zthxxx/STM32-Contiki_Sensor_Smart_Home/Doc/readme.txt

STM32串口驱动ESP8266 wifi模块STA TCP Client模式

引脚连接：
ESP8266_UTXD  --- STM32_A3(UART2_RXD)
ESP8266_URXD  --- STM32_A2(UART2_TXD)
ESP8266_VCC   --- STM32_3V3
ESP8266_GND   --- STM32_GND
ESP8266_RST   --- STM32_A1

配置路由器wifi SSID KEY、TCP Server后，开机自动连接  并发数据测试。
PC连接UART1，通信链路如下：
UART1 <--> UART2 <--> ESP8266 <--> 路由器 <--> TCP server
通信数据收发及显示均正常。
