zthxxx/STM32-Contiki_Sensor_Smart_Home/Documents/2016年四川省TI杯大学生电子设计竞赛题D-简易电子秤.docx

2016年TI杯

四川省大学生电子设计竞赛

D题：简易电子秤

设 计 报 告

日期：2016年 7月 28日

摘 要

本作品设计的是一个以电阻应变片为称重传感器的简易悬挂电子秤，被测重物体的重量值能在OLED屏幕上以克为单位精确的实时显示，并且可以进行单价设置，将自动换算物体的价格并同步实时显示，金额累加的功能可使得多次测量的累计总价显示观测。本电子秤也具有去皮校准、单位换算、超重报警等一系列功能。

本次题目要求测量范围为5.00g~500g，误差范围为不超过50g误差小于0.5g,50g至500g，误差小于1g；而本作品的电子秤称重范围可达1.00g~600g；重量小于50g，称重误差小于0.3g；重量在50g及以上，称重误差小于0.4g。

关键词：电子秤；电阻应变片；称重传感器；OLED显示

Abstract

This work is designed as a resistance strain gauge load cell suspension Simple electronic scales, the weight value of the measured object can be heavy on the OLED screen in grams accurate real-time display, and the unit price can be set to automatic conversion the price of the object and synchronizes real-time display, the amount of cumulative function makes multiple measurements show the cumulative total price observation. The electronic scales are calibrated with a peeled, unit conversion, and a series of overweight alarm function.

The measurement range of questions asked 5.00g ~ 500g, the error range of not more than 50g error is less than 0.5g, 50g to 500g, error is less than 1g; electronic weighing scales and scope of the work up to 1.00g ~ 600g; weight of less than 50g Weighing error is less than 0.3g; weight 50g and above, weighing error is less than 0.4g.

Keywords: Electronic scale; resistance strain gauges; weighing sensors; OLED display

目 录

简易电子秤（D题）

【本科组】

# 一、系统方案的论证

本系统主要由传感器模块、放大及AD转换模块、控制模块、显示模块、键盘模块、报警模块、电源模块组成。

## 1、自制传感器方案的论证与选择

根据本题目要求，称重传感装置需自制，悬臂梁需采用铁质材料。依据电阻应变效应及惠斯登电桥原理，在铁质悬臂梁上粘贴电阻应变片作为称重传感器。惠斯登电桥应变计有多重接线方式。

方案一：采用单臂电桥接线法。

单臂电桥接线方式如图1.1所示，利用应变片R1作为工作片，R2、R3、R3为固定电阻。应变片沿着受力方向平整安装在悬梁臂上，安装方式如图1.2所示。

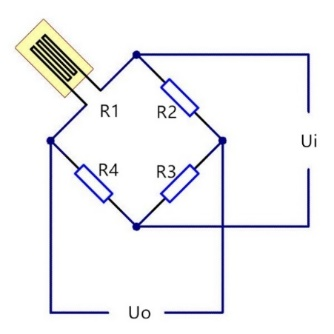
[picture p3: figure]
1_副本

图1.1 单臂电桥接线方式 图1.2 单臂电桥应变片安装方式

应变片本身灵敏度较低，铁质悬臂梁只产生轻微形变，所以采用单臂电桥接线方式构成的传感器灵敏度比较低。传感器输出的电压信号不利于的采集和处理。

方案二：双臂全桥接线法。

双臂全桥接线方式如图1.3所示，R1、R2、R3、R4四个应变片作为工作片，搭成惠斯登电桥。R1、R3平行安装在悬梁臂同一侧，R2、R4平行安装在悬梁臂另一侧，R1、R3和R2、R4的受力方向相反，安装方式如图1.4所示。

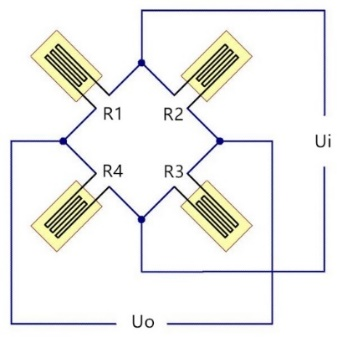
[picture p4: figure]
2_副本

图1.3 双臂全桥接线方式 图1.4 双臂全桥应变片安装方式

采用双臂全桥接线法构成的传感器的灵敏度为单臂电桥的4倍，并使输入和输出呈线性关系。利用桥式电路检测应变片的变化，还具有通过的电流极低，应变片自身发热低的优点。

综合以上两种方案，选择方案二作为自制传感器方案。

## 2、放大及AD转换电路的论证与选择

方案一：利用精密仪用放大器和AD转换芯片

利用精密仪用放大器,如INA128、INA129等搭建增益电路将传感器输出的微弱电压信号进行放大利于AD芯片的采集。利用AD转换芯片，如AD7705、AD7714等搭建AD转换电路将电压模拟信号转换为数字信号利于单片机对数据的处理。

此种方案是一种较为常规的微小电压采集方案，能满足本题目中设计的要求，但电路相对复杂，调试时较为麻烦。

方案二：利用专为高精度电子秤而设计的24位A/D转换器芯片HX711。HX711片内集成了低噪声可编程放大器，可编程增益为128或 64，对应的满额度差分输入信号幅值分别为±20mV或±40mV。芯片内提供的稳压电源可以直接向外部传感器和芯片内的 A/D 转换器提供电源。HX711采用简单的数字控制和串口通讯，所有控制由管脚输入，芯片内寄存器无需编程，便于单片机控制。

此方案利用专用芯片来实现电压增益和AD转换，能很好的完成对传感器微小电压的采集，外围电路简单，调试方便。

综合以上两种方案，选择方案二作为增益及A/D转换电路。

## 3、控制系统的论证与选择

方案一：使用ST公司的STM32F103RCT6单片机做为主控芯片，它以运行速度快以及性能稳定可靠而被广泛应用于一些需要复杂运算的工程中。

方案二：采用51系列单片机作为控制器，成本低，但所需外围电路复杂。存储容量较小，运行速度较慢。

根据本设计要求，综合以上两种方案，选择方案一的主控芯片。

## 4、显示模块的论证与选择

方案一：采用OLED作为显示器，OLED无需背光灯，采用非常薄的有机材料涂层和玻璃基板，当有电流通过时，这些有机材料就会发光。而且OLED显示屏幕可以做得更轻更薄，可视角度更大，并且能够显著节省电能。

方案二：采用LCD作为液晶显示屏，LCD本身不发光，需要背光源。其由TFT基板与CF（彩膜）基板贴合而成，内充液晶。通过TFT基板提供电场来控制液晶旋转的角度，从而起到控制液晶穿透率的作用。但LCD耗能相对较高。
根据本设计要求，综合以上两种方案，选择方案一。

# 二、系统理论分析与计算

## 1、电阻应变的分析

金属导线的电阻R与其长度L成正比，与其截面积A成反比，即 R=ρL/A ，其中ρ是导线的电阻率。如果导线沿其轴线方向受力产生形变，则其电阻值也随之发生变化，这一物理现象被称为金属导线的应变——电阻效应。当导线沿其轴线放线受力被拉长时，导线长度L增大，截面积A减小，导线的阻值R就会随之增大。反之，当导线沿其轴线放线受力被挤压时，导线的阻值R会随之减小。

本题目要求利用电阻应变片自制铁质传感器，铁质材料的导热能力强，温度因素对铁材料的物理属性影响较大，为了避免电阻应变片发热对铁质传感器形变造成影响，应尽量减小通过应变片电流，本设计选用的电阻应变片阻值为1000Ω。传感器输入电压Ui为5V左右，电阻桥的平衡阻值为： R=(（R2+R3）（R1+R4）)/(R1+R2+R3+R4)=1K ，流过应变片的电流约为： I=(Ui)/R=5mA 。

## 2、应变电阻桥的分析

应变电阻桥如图2.1所示，输入输出电压与应变电阻的关系如下：

Ui=((R1R3-R2R4)/((R1+R2)(R3+R4)))Uo (2-1)

R1R3=R2R4时，电阻桥为平衡桥。随着悬臂梁受重物的拉力而形变时应变电阻阻值发生改变：

ΔUi=Uo(R1R2)/((R1+R2)^2)((ΔR1)/(R1)-(ΔR2)/(R2)+(ΔR3)/(R3)-(ΔR4)/(R4)) (2-2)

为常数值，ε—金属材料的轴向应变值,即ε=ΔL/L，因此又称ε为长度应变值,对金属丝而言,其值在0.24~0.4之间）：

ΔUi=(KUo)/4(ε1-ε2+ε3-ε4) (2-3)

所以应变电阻全桥读数为单臂电桥的4倍。

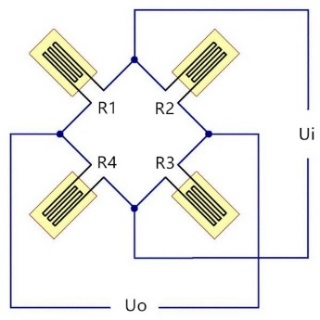
[picture p5: figure]
2_副本

图2.1 双臂全桥原理图

# 三、电路与程序设计

## 1、电路的设计

### （1）系统总体框图

系统总体框图如图3.1所示。

图3.1 系统总体框图

### （2）放大及AD转换电路原理图

放大及AD转换电路如图3.2所示，HX711片内稳压电路为自制重量传感器提供电源，传感器反馈的微弱模拟电压信号由HX711通道A正负输入端（INPA、INNA）进入芯片内进行放大和AD转换，AD转换后的数字信号通过简单的串口通讯（PD_SCK、DOUT）输入到单片机。将HX711 15脚RATE拉高，设定输出数据速率为80HZ。

图3.2 放大及AD转换电路

### （3）键盘输入、OLED显示及报警电路

本题目中电子秤需要进行数字输入，并且要实现单价去皮等功能，需要用到的按键较多，同时为了减少I/O口的占用，采用4x5矩阵键盘完成数字及功能输入。

显示部分采用1.3寸蓝色OLED显示屏，该显示屏采用SPI与单片机通信，纵向显示4行字符，纵向显示16个字符，能完成重量、价格及其他基本信息的显示。

报警电路由LED及蜂鸣器组成，低电平触发。

图3.3 键盘输入及OLED显示电路

### （4）控制系统电路原理图

图3.4 控制系统电路

### （5）电源模块

电源由两节18650电池加滤波部分、稳压部分组成。为整个系统提供+5V或者+3.3V电压，确保电路的正常稳定工作。18650锂电池可由电源适配器充电，为保证电池使用寿命，在充电时，电池与系统自动断开，系统断电。电路简单可靠，均采用三端稳压管实现，原理图如图3.5所示。

图3.5 电源模块电路

## 2、程序的设计

### （1）程序功能描述与设计思路

1、程序功能描述

根据题目要求软件部分主要分为称重传感器数据的采集、实现键盘的设置和显示。

1）键盘部分功能：单价设置输入、切换单位、实现价格累加和去皮功能。

2）显示部分：实现显示重量、价格、单价、总价、错误提示等功能。

2、程序设计思路

根据题目要求，将软件系统分为数据采集、界面显示、人机交互三大部分，各部分采用多个进程协同完成功能，每个进程职责单一。通过Contiki嵌入式操作系统进行各部分任务进程的调度。

1） 数据采集主要涉及AD芯片的读取，采集应变片变化，并通过数字滤波FIR处理数据，并转为所需要的重量数据。
2） 界面显示部分是将重量信息，价格、单价、总价等信息，统一格式显示在屏幕上。
3） 人机交互部分是通过按键队列产生按键事件驱动不同的进程响应操作，以实现设置单价、累加价格、去皮校零的逻辑功能。

### （2）程序流程图

1、主程序流程图

图3.6 系统主程序流程框图

2、测重子程序流程图

图3.7 测重流程图

测重部分软件难点在于原则合适的数字滤波器对噪声和干扰的过滤，选择合适的算法做偏差校正，此部分借助于Matlab等工具对测量数据进行分析，帮助滤波器的选择。

3、按键子程序流程图

图3.8 按键驱动流程图

本部分按键驱动程序仿照Linux系统中按键队列、消息机制及虚拟按键映射的实现过程，写出了对应本操作系统Contiki的实现代码。

4、交互业务子程序流程图

图3.9 交互业务实现流程图

业务进程均为独立进程，电子秤总进程直接获取按键事件，并根据需要按照按键类型触发所需要的具体应用业务进程，实现各功能模块与系统之间的松耦合。

# 四、测试方案与测试结果

## 1、测试方案

将电子秤放置于水平平稳桌面，为电子秤提供稳定电源，依次向托盘中放入不同重量的标称砝码，将砝码值和所测重量值记录于表中，反复测量3次，计算精度。然后再进行功能测试，先后测试电子秤的单价设置功能、物品金额计算功能、金额累加功能、去皮功能、单位换算功能，并将测试结果记录于表中。

## 2、测试条件与仪器

测试条件：检查多次，仿真电路和硬件电路必须与系统原理图完全相同，并且检查无误，硬件电路保证无虚焊。

测试环境：8.4V电池供电，室温28℃。

测试仪器：标准砝码。

## 3、测试结果及分析

### （1）测试结果(数据)

称重测试

测试结果如下表所示： （单位/g）

表4-1 重量测试结果表

砝码值 | 1 | 5 | 10 | 50 | 100 | 200 | 300 | 500 | 600
测试值 | 1.03 | 4.99 | 10.05 | 49.98 | 99.98 | 199.92 | 299.92 | 500.03 | 600.01
误差 | 0.03 | 0.01 | 0.05 | 0.02 | 0.02 | 0.08 | 0.08 | 0.03 | 0.01

功能测试与结果分析

测试结果如下表所示： （单位/g）

表4-2 功能测试结果表

功能 | 设置单价 | 计算金额 | 金额累加 | 去皮 | 去皮 | 单位换算 | 超重报警
设置值 | 10元/g | 10g重物 10元/g | 125元 累加5次 | 58g 去皮 | 101g 去皮 | 100g重物 | 502g重物
测试结果 | 10.00元/g | 100.00元 | 625.00元 | 0.00g | 去皮超重 | 10两 | 声光报警

### （2）测试分析与结论

根据上述对电子秤称重数据的分析和功能的验证，由此可以得出以下结论：

1、称重范围为1.00g~600g，超过题目要求；

2、称重误差全部在0.5g以下；

3、电子秤能够实现单价设置功能，并能实现相应的金额计算和累加；

4、能够实现去皮功能，去皮范围为100g；

5、能实现单位换算功能，能实现国际单位制（克）与中国市制（两）的换算；

6、当称重重量超过500g时，为保护电子秤超重声光报警触发。

综上所述，本设计达到设计要求。

# 五、结论与心得

自制传感器是本题目最大的难点，从铁质材料的选取到应变片的粘贴再到力臂的长度都需要考虑，任何一点因数或者干扰都会影响数据的读取。在我们不断的奋战中，在多组测试结果中选取了线性度高，自恢复性良好的材质，使用全桥方式的应变片贴法，再加上程序上给予的多种软件数字滤波组合，最终终于得到了稳定高精度的数据输出。种种困难并没有让我们放弃，在这次比赛的不断奋斗中，我们最终完成设计，达到要求。

# 六、参考文献

[1] 谭浩强.C语言程序设计[M].北京:清华大学出版社,2012

[2] 尹福严.金属箔式应变片制作原理 [M].北京:国防工业出版社,2011

[3] 刘鸿文.材料力学 第五版[M].北京:高等教育出版社,2011

[4] 周真，苑惠娟.传感器原理与运用[M].北京:清华大学出版社,2011

[5] 童敏明，唐守峰. 传感器原理与检测技术[M].北京:机械工业出版社,2014

# 附录1：电路原理图

# 附录2：源程序

PROCESS_THREAD(HX711_read_weight_process, ev, data)

{

double HX711_Weight = 0.0;

static struct etimer et;

PROCESS_BEGIN();

while(1)

{

if(HX711_Get_DAT_Pin_State())

{

Contiki_etimer_DelayMS(10);

}

HX711_Weight = HX711_Window_Weighting_Filter();

// printf("FLITER!! : %lf\r\n",HX711_Weight);

// printf("%d\r\n",HX711_Read_Value()/100);

HX711_Weight_GlobalData = HX711_Weight;

Steelyard_CurrentlyWeight = HX711_Weight;

}

PROCESS_END();

}

PROCESS_THREAD(OLED_Show_Increment_process, ev, data)

{

static struct etimer et;

static uint8_t last_length[2] = {16,16};

PROCESS_BEGIN();

while(1)

{

OLED_ShowFloat(

Steelyard_Weight_Row,

Steelyard_Display_Row_Head_Length[Steelyard_Weight_Row],

16 - Steelyard_Display_Row_Endding_Length[Steelyard_Weight_Row],

Steelyard_Convert_Unit_Weight_Method[Steelyard_Unit_index](HX711_Weight_GlobalData),

&last_length[0]

);

OLED_ShowFloat(

Steelyard_Price_Row,

Steelyard_Display_Row_Head_Length[Steelyard_Price_Row],

15,

Steelyard_Get_CurrentlyPrice(),

&last_length[1]

);

OLED_Refresh_Gram();//更新显示

Contiki_etimer_DelayMS(500);

}

PROCESS_END();

}

PROCESS_THREAD(Steelyard_Display_Peeling_Error_process, ev, data)

{

static struct etimer et;

PROCESS_BEGIN();

Steelyard_Display_Peeling_Overweight();

OLED_Refresh_Gram();//更新显示

Contiki_etimer_DelayMS(2000);

OLED_Fill_Alphabet(Steelyard_Peeling_Overweight_Row,0,16);

PROCESS_END();

}

PROCESS_THREAD(KEYBOARD_Scan_process, ev, data)//keyboard scan, follow the typical keyboard scan code

{

static uint8_t Keyboard_Button_Index = 0;

static struct etimer et;

PROCESS_BEGIN();

keyboard_press_event = process_alloc_event();

while(1)

{

Keyboard_Button_Index = KEYBOARD_Read_Button();

if(Keyboard_Button_Index == 0)

{

Contiki_etimer_DelayMS(50);

continue;

}

Contiki_etimer_DelayMS(50);

if(KEYBOARD_Read_Button() == Keyboard_Button_Index)

{

printf("Key down %d\r\n", Keyboard_Button_Index);

KEYBOARD_Push_Button_IntoQueue(Keyboard_Button_Index);

process_post(&Steelyard_Load_Key_process, keyboard_press_event, (void *)Keyboard_Button_Index);

Keyboard_Button_Index = 0;

}

while(KEYBOARD_Read_Button() != 0)

{

Contiki_etimer_DelayMS(50);//放开按键

}

//按键已释放

}

PROCESS_END();

}

PROCESS_THREAD(Steelyard_Load_Key_process, ev, data)

{

uint8_t key_index = NULL;

PROCESS_BEGIN();

while(1)

{

PROCESS_WAIT_EVENT_UNTIL(ev == keyboard_press_event);

while(KEYBOARD_Get_Button_Queue_Size() > 0)

{

key_index = KEYBOARD_Get_Top_Button();

if((key_index == NULL) || (Steelyard_Get_MapVirtualKey(key_index) == NULL))continue;

Steelyard_Key_Dispose_Method[Steelyard_Get_Key_Type(key_index)](Steelyard_Get_MapVirtualKey(key_index));

}

}

PROCESS_END();

}
