zthxxx/STM32-Contiki_Sensor_Smart_Home/Documents/resource/images/硬件系统框图.png

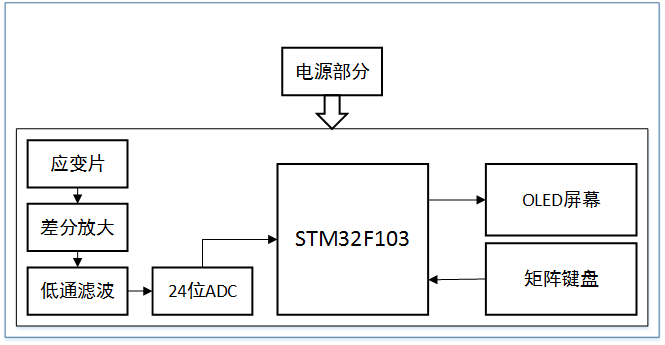
Documents/resource/images/硬件系统框图.png
