zthxxx/STM32-Contiki_Sensor_Smart_Home/Hardware/DHT11/dht11.c

#include "dht11.h"
#include "delay.h"

 //////////////////////////////////////////////////////////////////////////////////	 
//本程序只供学习使用，未经作者许可，不得用于其它任何用途
//ALIENTEK战舰STM32开发板
//DHT11数字温湿度传感器驱动代码	   
//正点原子@ALIENTEK
//技术论坛:www.openedv.com
//修改日期:2012/9/12
//版本：V1.0
//版权所有，盗版必究。
//Copyright(C) 广州市星翼电子科技有限公司 2009-2019
//All rights reserved									  
//////////////////////////////////////////////////////////////////////////////////
      
//复位DHT11
void DHT11_Out()
{
	GPIO_InitTypeDef  GPIO_InitStructure;
	GPIO_InitStructure.GPIO_Pin = DHT11_GPIO_Pin;
 	GPIO_InitStructure.GPIO_Mode = GPIO_Mode_Out_PP; 		 //推挽输出
 	GPIO_Init(DHT11_GPIO_Port, &GPIO_InitStructure);				 //初始化IO口
}
void DHT11_IN()
{
	GPIO_InitTypeDef  GPIO_InitStructure;
	GPIO_InitStructure.GPIO_Pin = DHT11_GPIO_Pin;
 	GPIO_InitStructure.GPIO_Mode = GPIO_Mode_IPU; 		 //推挽输出
 	GPIO_Init(DHT11_GPIO_Port, &GPIO_InitStructure);				 //初始化IO口
}
void DHT11_Rst(void)	   
{                 
	DHT11_Out(); 	//SET OUTPUT
    DHT11_DQ_OUT=0; 	//拉低DQ
    Delay_NOP_ms(50);    	//拉低至少18ms
    DHT11_DQ_OUT=1; 	//DQ=1 
	Delay_NOP_us(60);     	//主机拉高20~40us
}
//等待DHT11的回应
//返回1:未检测到DHT11的存在
//返回0:存在
uint8_t DHT11_Check(void) 	   
{   
	uint8_t retry=0;
	DHT11_IN();//SET INPUT	 
    while (DHT11_DQ_IN&&retry<100)//DHT11会拉低40~80us
	{
		retry++;
		Delay_NOP_us(1);
	};	 
	if(retry>=100)return 1;
	else retry=0;
    while (!DHT11_DQ_IN&&retry<100)//DHT11拉低后会再次拉高40~80us
	{
		retry++;
		Delay_NOP_us(1);
	};
	if(retry>=100)return 1;	    
	return 0;
}
//从DHT11读取一个位
//返回值：1/0
uint8_t DHT11_Read_Bit(void) 			 
{
 	uint8_t retry=0;
	while(DHT11_DQ_IN&&retry<100)//等待变为低电平
	{
		retry++;
		Delay_NOP_us(1);
	}
	retry=0;
	while(!DHT11_DQ_IN&&retry<100)//等待变高电平
	{
		retry++;
		Delay_NOP_us(1);
	}
	Delay_NOP_us(40);//等待40us
	if(DHT11_DQ_IN)return 1;
	else return 0;		   
}
//从DHT11读取一个字节
//返回值：读到的数据
uint8_t DHT11_Read_Byte(void)    
{        
    uint8_t i,dat;
    dat=0;
	for (i=0;i<8;i++) 
	{
   		dat<<=1; 
	    dat|=DHT11_Read_Bit();
    }						    
    return dat;
}
//从DHT11读取一次数据
//temp:温度值(范围:0~50°)
//humi:湿度值(范围:20%~90%)
//返回值：0,正常;1,读取失败
uint8_t DHT11_Read_Data(uint8_t *temp,uint8_t *temp0,uint8_t *humi,uint8_t *humi0)    
{        
 	uint8_t buf[5];
	uint8_t i;
    
    DHT11_Init();
    
	DHT11_Rst();
	if(DHT11_Check()==0)
	{
		for(i=0;i<5;i++)//读取40位数据
		{
			buf[i]=DHT11_Read_Byte();
		}
		if((buf[0]+buf[1]+buf[2]+buf[3])==buf[4])
		{
			*humi=buf[0];
			*humi0=buf[1];
			*temp=buf[2];
			*temp0=buf[3];
		}
	}else return 1;
	return 0;	    
}
//初始化DHT11的IO口 DQ 同时检测DHT11的存在
//返回1:不存在
//返回0:存在    	 
uint8_t DHT11_Init(void)
{	 
 	GPIO_InitTypeDef  GPIO_InitStructure;
 	
 	RCC_APB2PeriphClockCmd(RCC_APB2Periph_GPIOB, ENABLE);	 //使能PB端口时钟
	RCC_APB2PeriphClockCmd(RCC_APB2Periph_GPIOC, ENABLE);	 //使能PB端口时钟
 	GPIO_InitStructure.GPIO_Pin = DHT11_GPIO_Pin;				 //PB11端口配置
 	GPIO_InitStructure.GPIO_Mode = GPIO_Mode_Out_PP; 		 //推挽输出
 	GPIO_InitStructure.GPIO_Speed = GPIO_Speed_50MHz;
 	GPIO_Init(DHT11_GPIO_Port, &GPIO_InitStructure);				 //初始化IO口
    
 	GPIO_SetBits(DHT11_GPIO_Port,DHT11_GPIO_Pin);						 //PB11 输出高	
    return 1;
//	DHT11_Rst();  //复位DHT11
//	return DHT11_Check();//等待DHT11的回应
} 
