zthxxx/STM32-Contiki_Sensor_Smart_Home/Hardware/OLED/AsciiLib.c

/* Includes ------------------------------------------------------------------*/
#include "AsciiLib.h"

#ifdef ASCII_8X16_MS_Gothic

static unsigned char const AsciiLib[95][16] = {

{0x00,0x00,0x00,0x00,0x00,0x00,0x00,0x00,0x00,0x00,0x00,0x00,0x00,0x00,0x00,0x00},/*" ",0*/

{0x00,0x10,0x10,0x10,0x10,0x10,0x10,0x10,0x10,0x10,0x00,0x00,0x18,0x18,0x00,0x00},/*"!",1*/

{0x36,0x24,0x48,0x00,0x00,0x00,0x00,0x00,0x00,0x00,0x00,0x00,0x00,0x00,0x00,0x00},/*""",2*/

{0x00,0x24,0x24,0x24,0x24,0xFE,0x48,0x48,0x48,0x48,0xFC,0x48,0x48,0x48,0x48,0x00},/*"#",3*/

{0x10,0x38,0x54,0x92,0x92,0x50,0x30,0x18,0x14,0x12,0x92,0x92,0x54,0x38,0x10,0x00},/*"$",4*/

{0x00,0x62,0x92,0x94,0x94,0x68,0x08,0x10,0x20,0x2C,0x52,0x52,0x92,0x8C,0x00,0x00},/*"%",5*/

{0x00,0x30,0x48,0x48,0x48,0x48,0x30,0x20,0x54,0x94,0x88,0x88,0x94,0x62,0x00,0x00},/*"&",6*/

{0x30,0x30,0x10,0x20,0x00,0x00,0x00,0x00,0x00,0x00,0x00,0x00,0x00,0x00,0x00,0x00},/*"'",7*/

{0x04,0x08,0x10,0x10,0x20,0x20,0x20,0x20,0x20,0x20,0x20,0x10,0x10,0x08,0x04,0x00},/*"(",8*/

{0x40,0x20,0x10,0x10,0x08,0x08,0x08,0x08,0x08,0x08,0x08,0x10,0x10,0x20,0x40,0x00},/*")",9*/

{0x00,0x00,0x00,0x10,0x92,0x54,0x38,0x10,0x38,0x54,0x92,0x10,0x00,0x00,0x00,0x00},/*"*",10*/

{0x00,0x00,0x00,0x00,0x10,0x10,0x10,0xFE,0x10,0x10,0x10,0x00,0x00,0x00,0x00,0x00},/*"+",11*/

{0x00,0x00,0x00,0x00,0x00,0x00,0x00,0x00,0x00,0x00,0x00,0x30,0x30,0x10,0x20,0x00},/*",",12*/

{0x00,0x00,0x00,0x00,0x00,0x00,0x00,0x7C,0x00,0x00,0x00,0x00,0x00,0x00,0x00,0x00},/*"-",13*/

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

{0x00,0x00,0x00,0x00,0x00,0x63,0x6B,0x6B,0x6B,0x6B,0x36,0x36,0x00,0x00,0x00,0x00},/*"w",87*/

{0x00,0x00,0x00,0x00,0x00,0x66,0x66,0x3C,0x18,0x3C,0x66,0x66,0x00,0x00,0x00,0x00},/*"x",88*/

{0x00,0x00,0x00,0x00,0x00,0x66,0x66,0x66,0x66,0x66,0x66,0x3C,0x0C,0x18,0xF0,0x00},/*"y",89*/

{0x00,0x00,0x00,0x00,0x00,0x7E,0x06,0x0C,0x18,0x30,0x60,0x7E,0x00,0x00,0x00,0x00},/*"z",90*/

{0x00,0x00,0x00,0x0C,0x18,0x18,0x18,0x30,0x60,0x30,0x18,0x18,0x18,0x0C,0x00,0x00},/*"{",91*/

{0x00,0x00,0x00,0x18,0x18,0x18,0x18,0x18,0x18,0x18,0x18,0x18,0x18,0x18,0x18,0x00},/*"|",92*/

{0x00,0x00,0x00,0x30,0x18,0x18,0x18,0x0C,0x06,0x0C,0x18,0x18,0x18,0x30,0x00,0x00},/*"}",93*/

{0x00,0x00,0x00,0x71,0xDB,0x8E,0x00,0x00,0x00,0x00,0x00,0x00,0x00,0x00,0x00,0x00},/*"~",94*/
};

#endif



/*******************************************************************************
* Function Name  : GetASCIICode
* Description    : 
* Input          : 
* Output         : 
* Return         : None
* Attention		 : None
*******************************************************************************/
void GetASCIICode(unsigned char* pBuffer,unsigned char ASCII)
{  
   memcpy(pBuffer,AsciiLib[(ASCII - 32)] ,16);
}


/*********************************************************************************************************
      END FILE
*********************************************************************************************************/
