zthxxx/STM32-Contiki_Sensor_Smart_Home/Hardware/DHT11/dht11.h

#ifndef __DHT11_H
#define __DHT11_H 
#include "sys.h"   
//////////////////////////////////////////////////////////////////////////////////	 
//本程序只供学习使用，未经作者许可，不得用于其它任何用途
//ALIENTEK战舰STM32开发板
//DHT11数字温湿度传感器驱动代码	   
//正点原子@ALIENTEK
//技术论坛:www.openedv.com
//修改日期:2012/9/12
//版本：V1.0
//版权所有，盗版必究。
//Copyright(C) 广州市星翼电子科技有限公司 2009-2019
//All rights reserved									  
//////////////////////////////////////////////////////////////////////////////////

#define DHT11_GPIO_Pin  GPIO_Pin_13
#define DHT11_GPIO_Port GPIOC


////IO操作函数											   
#define	DHT11_DQ_OUT    PCout(13) //数据端口	PA0 
#define	DHT11_DQ_IN     PCin(13)  //数据端口	PA0 


uint8_t DHT11_Init(void);//初始化DHT11
uint8_t DHT11_Read_Data(uint8_t *temp,uint8_t *temp0,uint8_t *humi,uint8_t *humi0);//读取温湿度
uint8_t DHT11_Read_Byte(void);//读出一个字节
uint8_t DHT11_Read_Bit(void);//读出一个位
uint8_t DHT11_Check(void);//检测是否存在DHT11
void DHT11_Rst(void);//复位DHT11    
#endif
