zthxxx/STM32-Contiki_Sensor_Smart_Home/User/EXTI/exti.c

#include "exti.h"
#include "led.h"
#include "key.h"
#include "delay.h"
#include "usart.h"


//外部中断初始化程序
//初始化PA0,PA13,PA15为中断输入.
void EXTIX_Init(void)
{
  	GPIO_InitTypeDef GPIO_InitStructure;
 	EXTI_InitTypeDef EXTI_InitStructure;
 	NVIC_InitTypeDef NVIC_InitStructure;


  	GPIO_PinRemapConfig(GPIO_Remap_SWJ_JTAGDisable , ENABLE);	//关闭jtag

  	RCC_APB2PeriphClockCmd(RCC_APB2Periph_GPIOC|RCC_APB2Periph_AFIO,ENABLE);

 //init GPIOC.7	  下拉输入
  	GPIO_InitStructure.GPIO_Pin  = GPIO_Pin_7;
  	GPIO_InitStructure.GPIO_Mode = GPIO_Mode_IPD; 
  	GPIO_Init(GPIOC, &GPIO_InitStructure);


  //GPIOC.7
 	GPIO_EXTILineConfig(GPIO_PortSourceGPIOC,GPIO_PinSource7);

  	EXTI_InitStructure.EXTI_Line=EXTI_Line7;
  	EXTI_InitStructure.EXTI_Mode = EXTI_Mode_Interrupt;	
  	EXTI_InitStructure.EXTI_Trigger = EXTI_Trigger_Rising;
  	EXTI_InitStructure.EXTI_LineCmd = ENABLE;
  	EXTI_Init(&EXTI_InitStructure);

  
  	NVIC_InitStructure.NVIC_IRQChannel = EXTI9_5_IRQn;			//使能按键所在的外部中断通道
  	NVIC_InitStructure.NVIC_IRQChannelPreemptionPriority = 0x02;	//先占优先级4位,共16级
  	NVIC_InitStructure.NVIC_IRQChannelSubPriority = 0x02;					//先占优先级0位,从优先级4位
  	NVIC_InitStructure.NVIC_IRQChannelCmd = ENABLE;								//使能外部中断通道
  	NVIC_Init(&NVIC_InitStructure);  	
}

 
void EXTI9_5_IRQHandler(void)
{
    delay_ms(10);    //消抖
  	if(EXTI_GetITStatus(EXTI_Line7) != RESET)	  //检查指定的EXTI7线路触发请求发生与否
	{	  
		LED0=!LED0;
		LED1=!LED1;	
	}
	EXTI_ClearITPendingBit(EXTI_Line7);  //清除EXTI7线路挂起位
}
 
