zthxxx/STM32-Contiki_Sensor_Smart_Home/Hardware/E30TTL100/E30TTLUART.c

#include "E30TTLUART.h"
#include "delay.h"

uint16_t E30TTLUART_Appoint_Target_Address = 0x0000;
uint8_t E30TTLUART_Appoint_Target_Channel = 0x50;

void (*E30TTLUART_SendBytesData)(uint8_t *USART3_SendBuff, uint16_t DataSendLength);
uint8_t E30TTLUART_AppointSendMaxLength = 58;//指定传输时分包大小 



void E30TTLUART_Init(void)
{	 
 	GPIO_InitTypeDef  GPIO_InitStructure;
 	
 	RCC_APB2PeriphClockCmd(RCC_APB2Periph_GPIOB, ENABLE);	 //使能PB端口时钟
 	GPIO_InitStructure.GPIO_Pin = E30TTLUART_M0_Pin;
 	GPIO_InitStructure.GPIO_Mode = GPIO_Mode_Out_PP; 		 //推挽输出
 	GPIO_InitStructure.GPIO_Speed = GPIO_Speed_50MHz;
 	GPIO_Init(E30TTLUART_M0_Port, &GPIO_InitStructure);

	GPIO_InitStructure.GPIO_Pin = E30TTLUART_M1_Pin;
 	GPIO_InitStructure.GPIO_Mode = GPIO_Mode_Out_PP; 		 //推挽输出
 	GPIO_InitStructure.GPIO_Speed = GPIO_Speed_50MHz;
 	GPIO_Init(E30TTLUART_M1_Port, &GPIO_InitStructure);

	GPIO_InitStructure.GPIO_Pin = E30TTLUART_AUX_Pin;
 	GPIO_InitStructure.GPIO_Mode = GPIO_Mode_IN_FLOATING;    //浮空输入
 	GPIO_Init(E30TTLUART_AUX_Port, &GPIO_InitStructure);
    
    GPIO_ResetBits(E30TTLUART_M0_Port,E30TTLUART_M0_Pin);
    GPIO_ResetBits(E30TTLUART_M1_Port,E30TTLUART_M1_Pin);
    
    USART3_Config(115200);
} 

void E30TTLUART_ChangeMode(uint8_t E30TTLUART_mode)
{
    while(E30TTLUART_AUX_IN == 0);//为低电平则说明忙，因此等待
    if(E30TTLUART_mode>3)return;
    E30TTLUART_M0_OUT = E30TTLUART_mode & 0x01;
    E30TTLUART_M1_OUT = (E30TTLUART_mode>>1) & 0x01;
    while(E30TTLUART_AUX_IN == 0);
}

void E30TTLUART_Resetting()
{
    E30TTLUART_ChangeMode(3);
    E30TTLUART_SendOneByte(0xC4);//复位指令
    E30TTLUART_SendOneByte(0xC4);
    E30TTLUART_SendOneByte(0xC4);
    Delay_NOP_ms(1);
    while(E30TTLUART_AUX_IN == 0);
    Delay_NOP_ms(2);
}

void E30TTLUART_Config(uint16_t E30TTLUART_Address,uint8_t E30TTLUART_Channel,FunctionalState isPoint2Point)    //配置时波特率9600，模块工作波特率配置为115200
{
    uint8_t count;
    uint8_t configParameter[6];//默认初始配置参数值
    E30TTLUART_ChangeBaudRate(9600,DISABLE);
    E30TTLUART_ChangeMode(E30TTLUART_MODE_3);
    configParameter[0] = 0xC0;
    configParameter[1] = (uint8_t)(E30TTLUART_Address>>8);
    configParameter[2] = (uint8_t)(E30TTLUART_Address & 0x00FF);
    configParameter[3] = 0x3F;
    configParameter[4] = E30TTLUART_Channel;
    configParameter[5] = 0xC4;
    
    if(isPoint2Point == ENABLE)
    {
        configParameter[5] |= 0x80;//最高位置1为定点传输
        E30TTLUART_SendBytesData = E30TTLUART_AppointSendBytesData;
    }
    else
    {
        configParameter[5] &= 0x7F;//最高位置为透明传输
        E30TTLUART_SendBytesData = E30TTLUART_TransparentSendBytesData;
    }
    
    for(count=0;count<sizeof(configParameter);count++)
    {
        E30TTLUART_SendOneByte(configParameter[count]);
    }
    Delay_NOP_ms(2);
    E30TTLUART_Resetting();//改变参数后要复位
    
    E30TTLUART_ChangeMode(E30TTLUART_MODE_0);
    E30TTLUART_ChangeBaudRate(115200,ENABLE);    
}

void E30TTLUART_MultiCountConfig(uint16_t E30TTLUART_Address,uint8_t E30TTLUART_Channel,FunctionalState isPoint2Point,uint8_t reConfigTimes)
{
    while(reConfigTimes--)
    {
        E30TTLUART_Config(E30TTLUART_Address,E30TTLUART_Channel,isPoint2Point);
    }
}
void E30TTLUART_TransparentSendBytesData(uint8_t *bytesBuf, uint16_t bytesBufLength)
{
    while(bytesBufLength > 0xFF)
    {
        while(E30TTLUART_AUX_IN == 0);
        E30TTLUART_UART_SendBytesBuf(bytesBuf, 0xFF);
        bytesBuf += 0xFF;
        bytesBufLength -= 0xFF;
    }
    while(E30TTLUART_AUX_IN == 0);
    E30TTLUART_UART_SendBytesBuf(bytesBuf, bytesBufLength);
}

void E30TTLUART_Point2PointSendBytesData(uint16_t address,uint8_t channel,uint8_t* bytesBuf, uint16_t bytesBufLength)
{
    uint8_t targetPosition[3];
    uint8_t count;
    targetPosition[1] = (uint8_t)(address & 0x00FF);
    targetPosition[0] = (uint8_t)(address>>8);
    targetPosition[2] = channel;
    while(bytesBufLength > E30TTLUART_AppointSendMaxLength)
    {
        while(E30TTLUART_AUX_IN == 0);
        for(count=0;count<sizeof(targetPosition);count++)E30TTLUART_SendOneByte(targetPosition[count]);
        E30TTLUART_UART_AppointSendBytesBuf(bytesBuf, E30TTLUART_AppointSendMaxLength);

        bytesBuf += E30TTLUART_AppointSendMaxLength;
        bytesBufLength -= E30TTLUART_AppointSendMaxLength;
        Delay_NOP_us(10);
    }
    while(E30TTLUART_AUX_IN == 0);
    for(count=0;count<sizeof(targetPosition);count++) E30TTLUART_SendOneByte(targetPosition[count]);
    E30TTLUART_UART_AppointSendBytesBuf(bytesBuf, bytesBufLength); 
}


void E30TTLUART_AppointSendBytesData(uint8_t *bytesBuf, uint16_t bytesBufLength)
{
    E30TTLUART_Point2PointSendBytesData(E30TTLUART_Appoint_Target_Address, E30TTLUART_Appoint_Target_Channel, bytesBuf, bytesBufLength);
}
