zthxxx/STM32-Contiki_Sensor_Smart_Home/User/contiki-code/platform/c64/contiki-conf.h

/*
 * Copyright (c) 2007, Swedish Institute of Computer Science.
 * All rights reserved. 
 *
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
 * This file is part of the Contiki operating system.
 * 
 * Author: Oliver Schmidt <ol.sc@web.de>
 *
 * $Id: contiki-conf.h,v 1.27 2010/10/23 13:48:06 oliverschmidt Exp $
 */

#ifndef __CONTIKI_CONF_H__
#define __CONTIKI_CONF_H__

#include "6502def.h"

#define CTK_CONF_MENU_KEY         CH_F1
#define CTK_CONF_WINDOWSWITCH_KEY CH_F3
#define CTK_CONF_WIDGETUP_KEY     CH_F5
#define CTK_CONF_WIDGETDOWN_KEY   CH_F7

#define MOUSE_CONF_XTOC(x) ((x) / 8)
#define MOUSE_CONF_YTOC(y) ((y) / 8)

#define BORDERCOLOR       COLOR_BLACK
#define SCREENCOLOR       COLOR_BLACK
#define BACKGROUNDCOLOR   COLOR_BLACK
#define WINDOWCOLOR       COLOR_GRAY3
#define WINDOWCOLOR_FOCUS COLOR_GRAY3
#define WIDGETCOLOR       COLOR_GRAY3
#define WIDGETCOLOR_FOCUS COLOR_YELLOW
#define WIDGETCOLOR_FWIN  COLOR_GRAY3
#define WIDGETCOLOR_HLINK COLOR_CYAN

#define EMAIL_CONF_WIDTH  39
#define EMAIL_CONF_HEIGHT 20
#define EMAIL_CONF_ERASE   0

#define FTP_CONF_WIDTH  18
#define FTP_CONF_HEIGHT 22

#define IRC_CONF_WIDTH  40
#define IRC_CONF_HEIGHT 24

#define WWW_CONF_WEBPAGE_WIDTH      40
#define WWW_CONF_WEBPAGE_HEIGHT     20
#define WWW_CONF_HISTORY_SIZE        4
#define WWW_CONF_MAX_URLLEN         80
#define WWW_CONF_MAX_NUMPAGEWIDGETS 20
#define WWW_CONF_RENDERSTATE         1
#define WWW_CONF_FORMS               1
#define WWW_CONF_MAX_FORMACTIONLEN  20
#define WWW_CONF_MAX_FORMNAMELEN    20
#define WWW_CONF_MAX_INPUTNAMELEN   20
#define WWW_CONF_MAX_INPUTVALUELEN  20

#endif /* __CONTIKI_CONF_H__ */
