zthxxx/STM32-Contiki_Sensor_Smart_Home/(commit log)

2016-04-13 1) Project for STM32 ESP8266 UART drive. 2) This drive is work successful now. 3) Then todo is reconfigura code for modularity and extend function.
2016-04-14 1) Config wifi module auto into connect wifi and tcp server. 2) If it connected , it will auto into transparent transmission, 3) UART1 -> UART2 and UART2 -> UART1 test is pass. 4) Then todo change ua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
2016-04-14 1) Add UART2 send DMA proxy. 2) If UART2 interrupt on,the receive byte will crash.
    [bsp_gpio.c, bsp_usart1.c, bsp_usart2.c, bsp_usart2.h, dma.c]
2016-04-14 1) Fixed UART2 receive interrupt crash. 2) Send and receive data test successful. 3) Receive UART2 can be fast,but send UART1 can't.
    [bsp_gpio.c, bsp_usart1.c, bsp_usart2.c, main.c, wifi_config.c]
2016-04-15 1) Last bug of UART2 receive data can't not be fast and large is cause of USART_FLAG_ORE. 2) Now fix it by USART_GetFlagStatus(USART, USART_FLAG_ORE).
    [bsp_gpio.c, bsp_usart2.c]
2016-04-16 1) Porting ContikiOS successful! 2) Wifi connect normal. 3) Send and recive data normal. 4) GPIO Led blink normal. 5) On the contiki run a demo of Led blink and send data,demo running is normal.
2016-04-16 1) Add contiki-code because of push on Github is not complete.
    [1000pkt-64len.csv, arm7_wig.cfg, arm7_wig_flash.cfg, arm7_wig_reset.cfg, atari.cfg, dummy.cfg, sample.cfg, wwwroot.cfg]
2016-04-16 1) Add watch dog of 2 seconds.Try to solve lock jammed.
    [main.c]
2016-04-23 1) Wifi module work well until now. 2) Then try to add function of spi.
2016-04-23 1) Add function send spi1 data,but not to add recevise function. 2) System and all function is work well. 3) Then try to add receiese spi data and try use dma.
2016-04-24 1) Now link layer is TCPServer <--> TCPClient(wifiModule) <--> UART2 <--> UART1 <--> PCSerial. 2) Then try to use uart1 <--> SPI1 <--> SPI2 <--> UART2.
2016-04-24 1) SPI1 interrupt work well. 2) Now try to add function SPI2.
2016-04-24 1) SPI1 and SPI2 send is ok,OLED is light. 2) But send data will trigger receive interrupt.
2016-04-24 1) SPI1 and SPI2 send well after I add return if TXE==RESET. 2) Then try to SPI1 <--> SPI2.
    [SPI.c, wifi_config.c]
2016-04-25 1) Now SPI1 Master --> SPI2 Slave. 2) The SPI receive interrupt is wrong. 3) Now the SPI receive interupt working only when hard system poweron and continuation to receive,if delay time more than 200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
    [SPI.c, main.c, oled.c, wifi_config.c]
2016-04-25 1) Add exit of wait RXEN in spi1 send,and del delay of spi1 send ,then the spi2 receive interrupt is all work and uart1 send also well. 2) But add delay is crash.
    [SPI.c, wifi_config.c]
2016-04-29 1) Del SPI1 receive interrupt,then SPI send interval time can more than 50 us.
2016-04-30 1) SPI debug pause now. It NOT work yet. :( 2) Then try to merge other sensor module in the project now ,to make it complete.
    [SPI.c, wifi_config.c]
2016-04-30 1) Straighten code frame of module. 2) OLED and WIFI work well.
2016-04-30 1) Add ADC and MQ02 Function into system.
2016-05-01 1) Add function of Ultrasonic measure distance with HCSR04 module. 2) But the measure method with EXTI and Timer is not sensible.
2016-05-01 1) Amend method of measure distance with ultrasoic to use TIMER4 Catch.
2016-05-01 1) Add Light Sensor BH1750 whith analog IIC.
2016-05-01 1) Now periodicity finish task of add sensors. 2) All the module have pass the unit test. 3) But Not Add function to deal with data. 4) TODO: Add fingerprint module, RF cardreader, stepper motor, and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
2016-05-02 1) Amend code frame. 2) Move process into ProcessTask.h .c. 3) Add NVIC manager code.
2016-05-03 1) Fix RC522 RFID Read Card while bug.
    [ProcessTask.c, RC522.c, RC522.h, main.c]
2016-05-06 1) Add process to send all sensor data to wifi. 2) Change PacketID and FunctionWord position.
2016-05-06 1) Fix a bug of cJSON men manager(not free cJSON print out before).But I still don't think it have problem in the previous. 2) Amend some details, print JSON and it`s len to USART1 for debug;
    [ProcessTask.c, main.c]
2016-05-09 1) Add USART1 DMA send data.Test is well. 2) Amend interrupt index. 3) Then try to complete communication protocol receive part.
2016-05-14 1) Fix E30-TTL-100 Appoint target send bug with USART3 DMA.
    [E30TTLUART.c, E30TTLUART.h, bsp_usart3.c, main.c]
2016-05-14 1) Really fixed the bug of E30-TTL-100 change mode and config and send. 2) Delay time worry was the primary cause of this problems. 3) Make appoint mode and free model convenient easy.
    [E30TTLUART.c, E30TTLUART.h, main.c]
2016-05-14 1) This is Sensor part,then try to test terminal.
2016-05-14 1) Terminal first code ,it can work but sometime will reboot.
    [E30TTLUART.c, bsp_usart1.c, bsp_usart2.c, bsp_usart3.c, main.c]
2016-05-17 1) Fixed some bug of received packet. 2) Print log of packetIndex and packetLength. 3) But no fixed completely,it also breakdown at uncertainty time.
2016-05-17 1) Add PM2.5 sensor SDS01.
2016-05-17 1) Fix some small bug of communication protocol receive and deal with packet block,it still breakdown sometime,but not often. 2) Amend ESP8266 drive ,faster connnection and stm32 hot reboot would not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
    [ProcessTask.c, bsp_usart2.c, bsp_usart2.h, main.c, wifi_config.c]
2016-05-18 1) Amend terminal receive when terminal mount the sensor and send json with itself.
2016-05-18 1) Change into node mode. 2) Amend HC-SR04 Targ pin into STM32_PA8.
2016-05-18 1) Add SHT15 sensor to get accurate temperature. 2) Amend contiki sensor process control method.
2016-05-18 1) Amend E30TTL100 Send larger than 0xFF bug.
    [E30TTLUART.c, E30TTLUART.h, ProcessTask.c, main.c]
2016-05-18 1) Amend USART DMA send not block and cover data problem.
    [E30TTLUART.c, E30TTLUART.h, bsp_uart4.c, bsp_usart1.c, bsp_usart2.c, bsp_usart3.c]
2016-05-19 1) Adjust communication protocel with packetQueueManger. 2) Adjust USART DMA config code.
2016-05-19 1) Amend USART DMA method of send,make USART DMA async and not block. 2) Amend some point make it to NULL after free it.
2016-05-19 1) Adjust DMA method of Free_USART_DMA_PacketNoedItem.
2016-05-19 1) Add UART5 module,but UART5 not support DMA.
2016-05-20 1) Change HC-SR501 pin. 2) Shield the SHT15,because it look like worry.
2016-05-21 1) Fix HC-SR04 GPIOB RCC bug.
    [HC-SR04.c]
2016-05-22 1) Adjustment communication protocol code frame. 2) Make it into multi files with different function.
2016-05-23 1) Amend Protocol send interface auto set. 2) Change w5500 socket link remote server.
2016-05-23 1) Fixed W5500 init socket port bug. 2) Make STM32 inside Flash to save rand srand seed.
    [ProcessTask.h, W5500.c, main.c, w5500.h]
2016-05-28 1) Add steelyard function most, and method test is pass except adjust weight,because NOT complete adjust weight method. 2) All the code frame is bad!It need reconfiguration and rewrite!
2016-05-28 1) Amend Steelyard code frame first, but NOT complete.
2016-05-28 1) Fix HX711 window filter bug.
    [HX711.c]
2016-05-29 1) Adjust filter code frame.
2016-05-30 1) Fix unit price bug. 2) Add peeling limit and overweight display.
    [HX711.c, ProcessTask.c, ProcessTask.h]
2016-05-30 1) Fixed HX711_Read_Average_Value type of return value.
    [HX711.c]
2016-05-30 1) Fixed 500g red_LED blink bug.
    [ProcessTask.c]
2016-05-30 1) Fixed check weight bug.
    [HX711.c]
2016-06-08 1) Recover project after reinstall system. 2) Fix Esp8266 wifi link check bug with 'AT' send. 3) Now it`s node mode.
    [main.c]
2016-06-15 1) Change HC-SR501 PIN from IPU into IPD.
2016-07-17 1) Add UART4 send and receive and DMA_send. 2) Try to add SDS01 PM2.5 sensor.
2016-07-17 1) Fix SDS01 protocol receive analyze bug.
    [ProcessTask.c]
2016-07-17 1) Amend some commentary and #ifdefind with SDS01 process. 2) Make terminal can mount sensor eg SDS01 sensor.
2016-10-02 1) Fixed ‘---------’ newline not show bug.
