zthxxx/STM32-Contiki_Sensor_Smart_Home/(notices)

Notices in the files:
User/EXTI/exti.h:
Copyright(C) ÕýµãÔ­×Ó 2009-2019
All rights reserved
Hardware/DHT11/dht11.h:
Copyright(C) ¹ãÖÝÊÐÐÇÒíµç×Ó¿Æ¼¼ÓÐÏÞ¹«Ë¾ 2009-2019
